GroundStudio/Jade_U1Plus/README.md

GroundStudio Jade U1+
====================================
JadeU1+

Get it from [ardushop.ro](https://ardushop.ro/ro/118-groundstudio)

Explore all the GroundStudio products at [GroundStudio.ro](https://groundstudio.ro/)

Description
-------------------
Development board based on ATmega328PB chip.

Contents
-------------------

* [/Documentation](https://github.com/GroundStudio/Jade_U1Plus/tree/main/Documentation) -- Contains documentation written during creation of this repository, with readme.md index of its own!
* [/Firmware](https://github.com/GroundStudio/Jade_U1Plus/tree/main/Firmware) -- Firmware (bootloaders, etc)
* [/Hardware](https://github.com/GroundStudio/Jade_U1Plus/tree/main/Hardware) -- Schematics, layout.
* [/Libraries](https://github.com/GroundStudio/Jade_U1Plus/tree/main/Libraries) -- Arduino/CircuitPython libraries. 
* [/Tools](https://github.com/GroundStudio) -- Tools needed for compiling, uploading bootloader, etc.

Versions
-------------------
*(Not all tags shown)*
* [V1.1.0] Initial version

License
-------------------

This is released under the [Attribution-ShareAlike 4.0 International (CC BY-SA 4.0)](https://creativecommons.org/licenses/by-sa/4.0/) license. 
**You are welcome to use this for commercial purposes.**

Please consider contributing back to this project or others to help the open-source hardware community continue to thrive and grow! 

Certifications:

[Open Source Hardware Association](https://certification.oshwa.org/ro000024.html)   
   
certification-mark-RO000024-wide (https://certification.oshwa.org/ro000024.html)
