GroundStudio/Jade_U1Plus/Documentation/REV1.1.0/REV1.1.0 OLMPHC_GS Jade U1+ Pinout.pdf

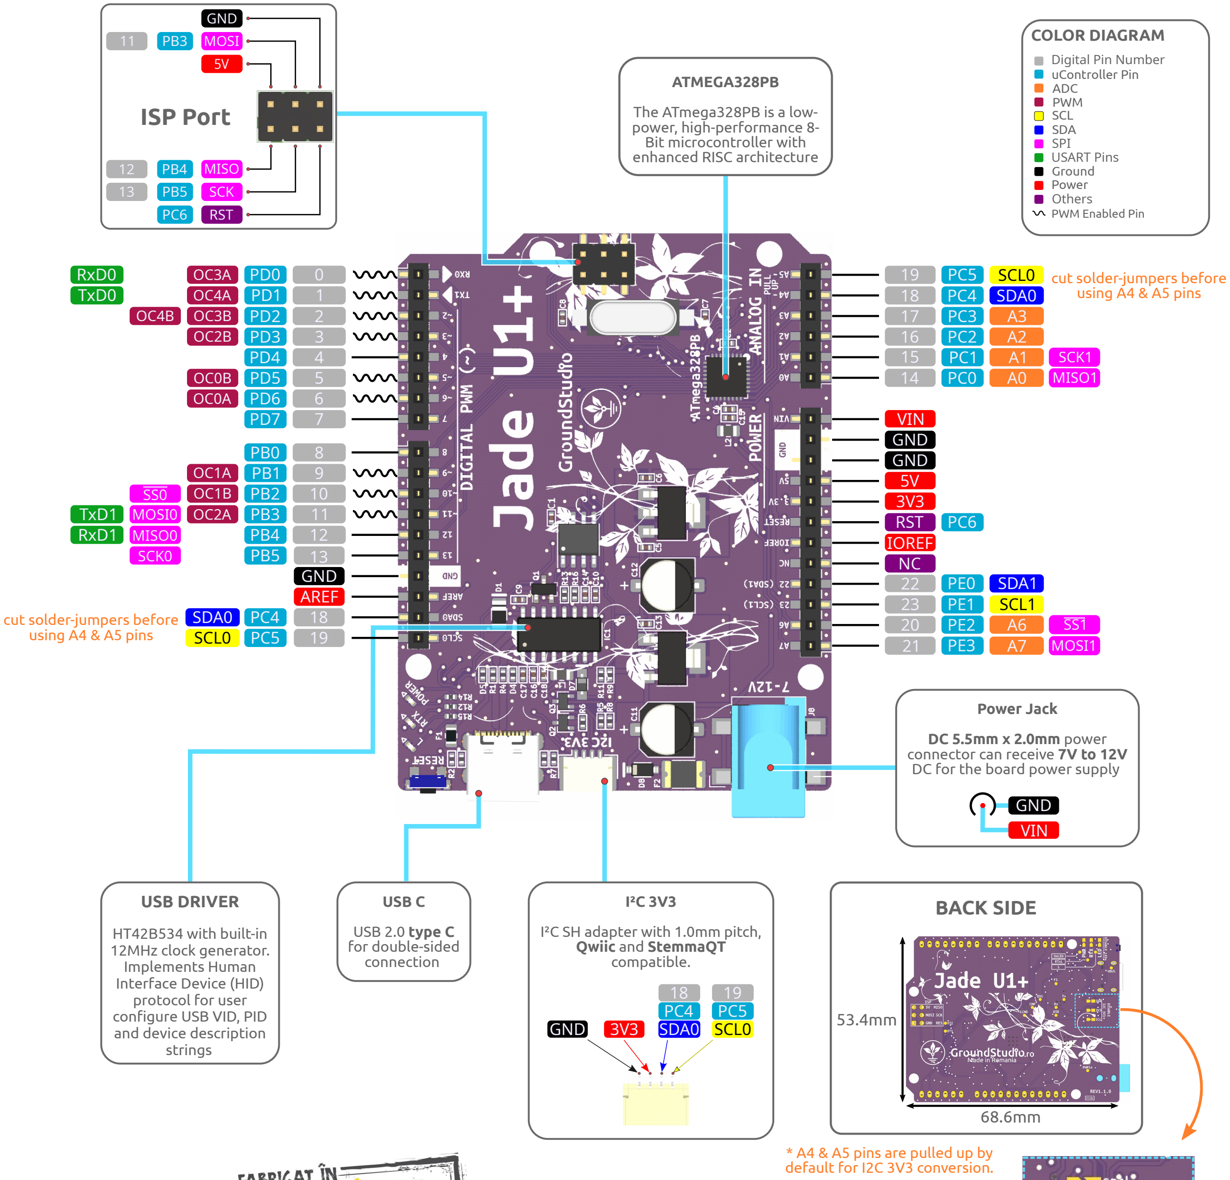
[picture p1: figure]
cut solder-jumpers before; using A4 & A5 pins; SDA0; SCL0; Digital Pin Number; SPI USART Pins; Others; uController Pin; COLOR DIAGRAM; ADC; SDA; SCL; Ground Power; ATMEGA328PB; The ATmega328PB is a low- power, high-performance 8- Bit microcontroller with enhanced RISC architecture; ISP Port; GND MOSI 5V; PB5 SCK; MISO; RST; MISO0; TxD0; RxD0; SCK0; AREF; GND; VIN; RST PC6; IOREF; Power Jack; DC 5.5mm x 2.0mm power connector can receive 7V to 12V DC for the board power supply; USB C; USB 2.0 type C for double-sided connection; USB DRIVER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
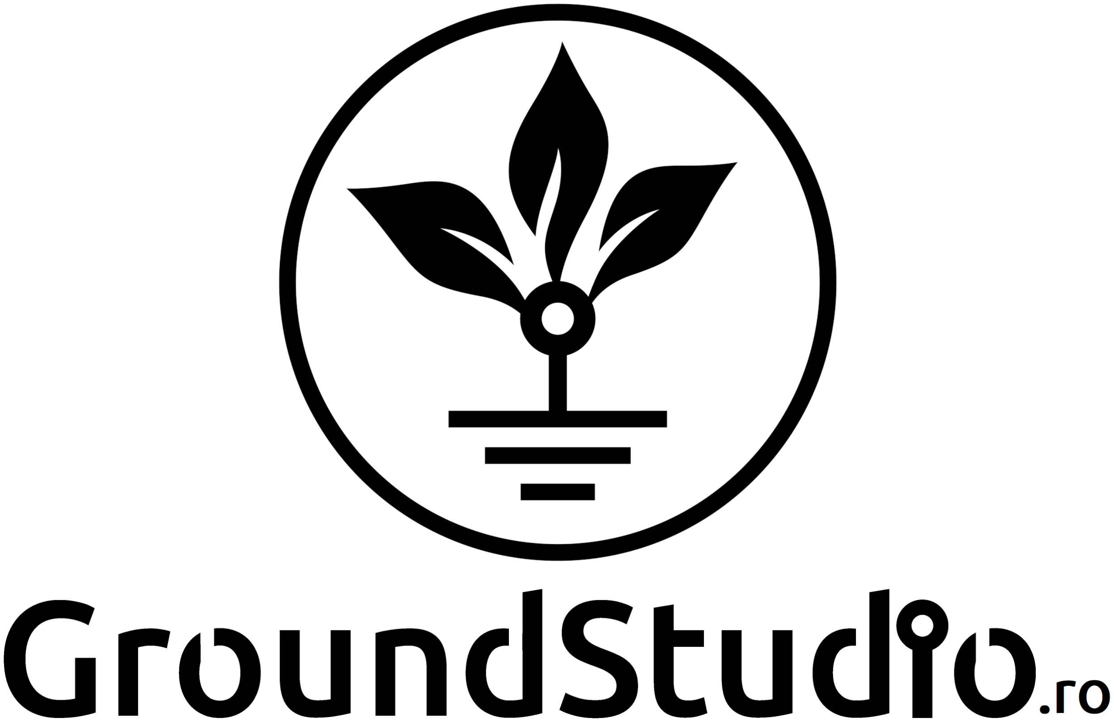
[picture p2: figure]

Board:

Credits: "Arduino UNO REV3" by Arduino (https://www.arduino.cc/en/uploads/Main/Arduino_Uno_Rev3-schematic.pdf) "GroundStudio Jade U1+" OLMPHC_GS REV 1.1.0

Copyright:

License:

ARDUSHOP SRL 2024

Attribution-ShareAlike 4.0 International

CC BY-SA 4.0 | Pinout REV: 1

# GroundStudio Jade U1+

ATMEGA328PB based development board featuring picoPower® technology for better power management, Peripheral Touch Controller (PTC), 32kBytes of In-System Self-Programmable Flash program memory, 1kBytes EEPROM, 2kBytes Internal SRAM, 10 PWM Channels, 24 Digital Pins, 2 USART, 2 SPI, 2 I²C ports with an I2C 3V3 adapter on port 0 (default) and 8 ADC Pins with 10 bit Resolution

This will cause the pins to always be HIGH!

To use A4 & A5 as regular pins detach them first from I2C 3V3 connector by cutting the solder jumpers on the backside of the pcb.
