GroundStudio/Jade_U1Plus/Documentation/REV1.1.0/REV1.1.0 OLMPHC_GS Jade U1+ Schematic.pdf

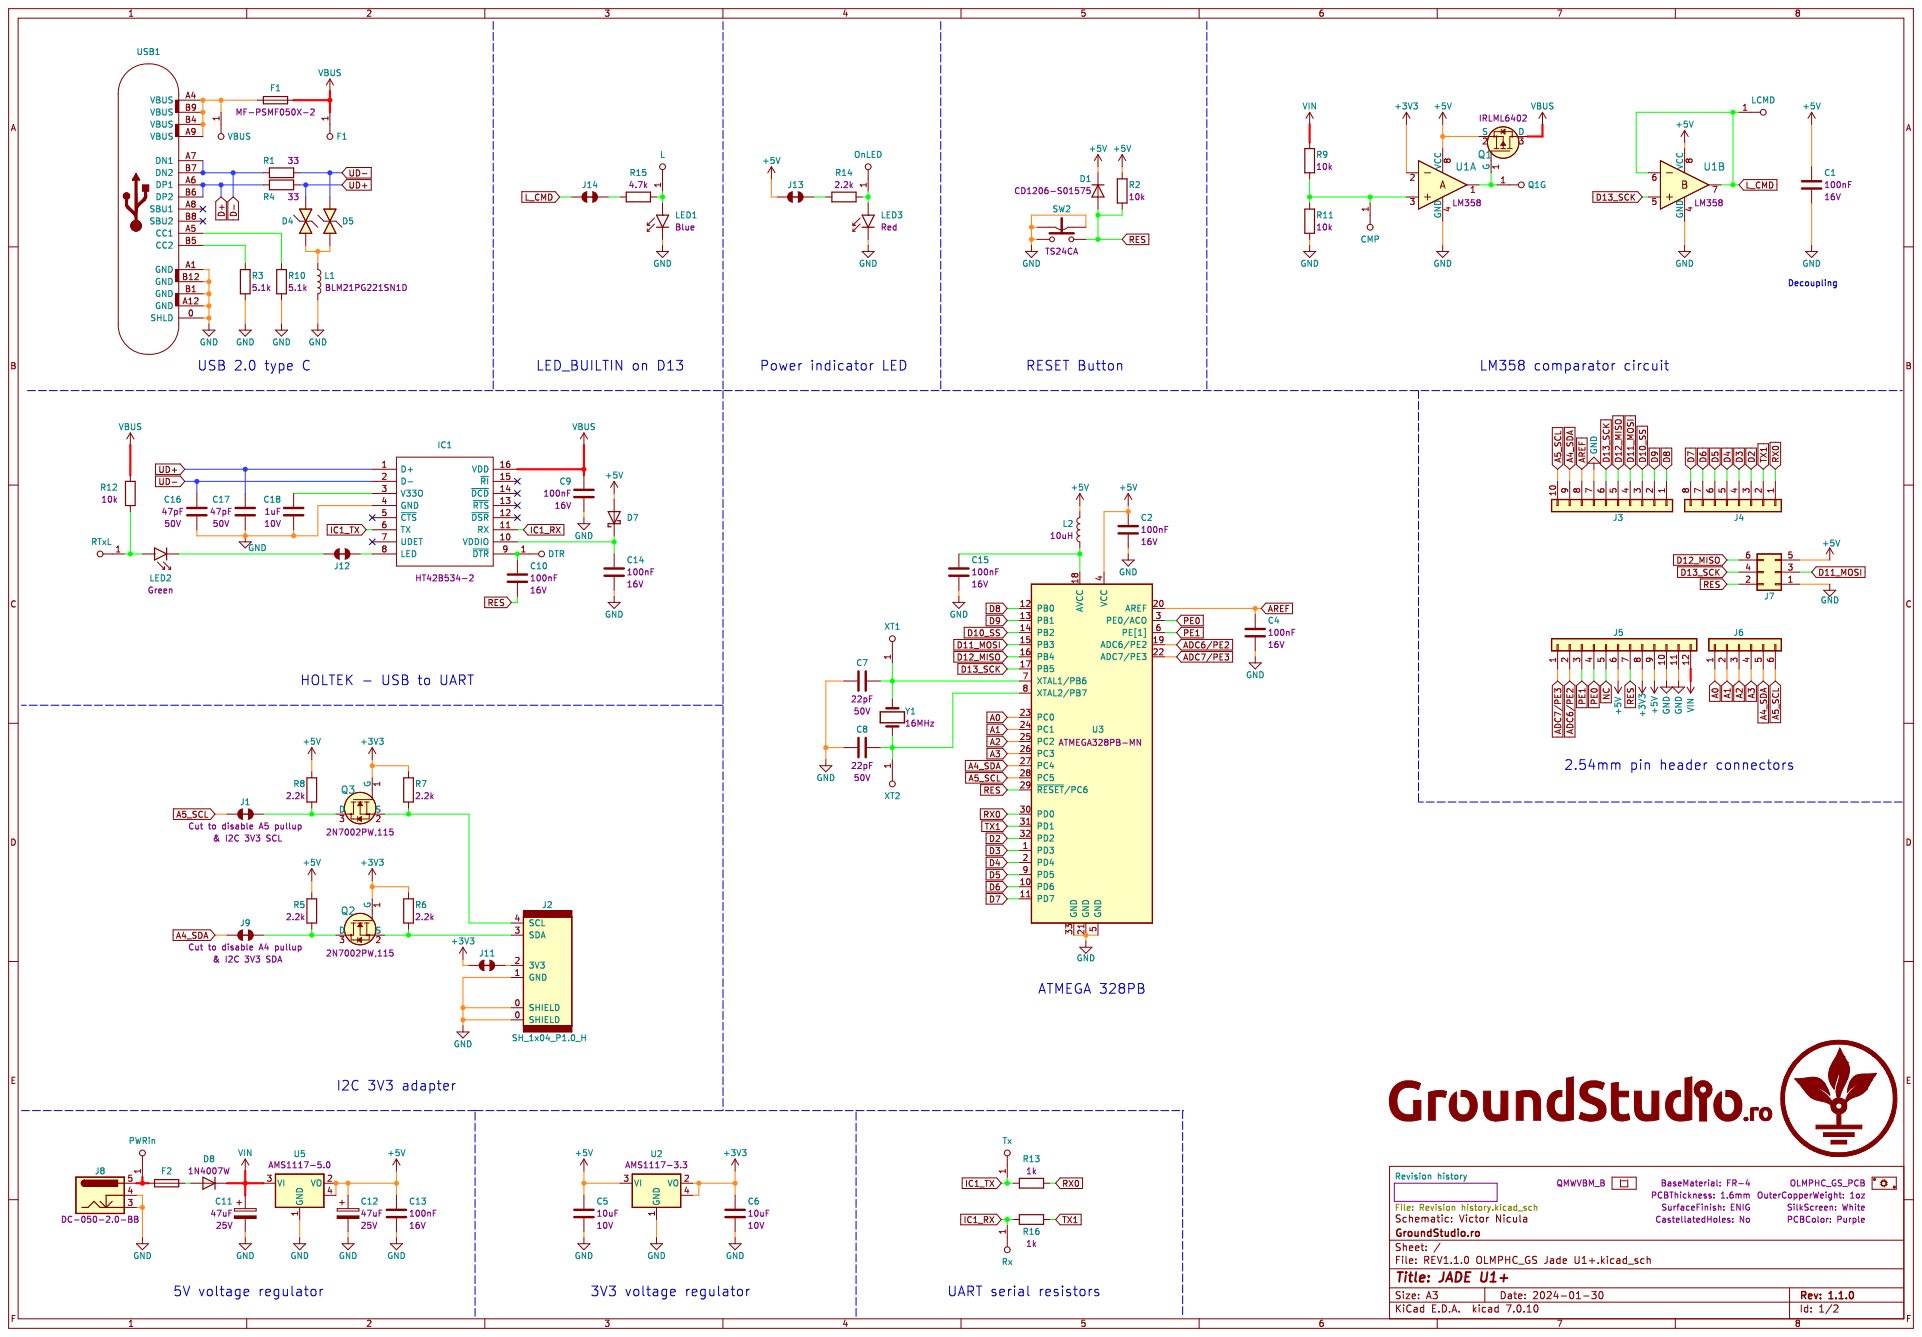
[picture p3: page 1]

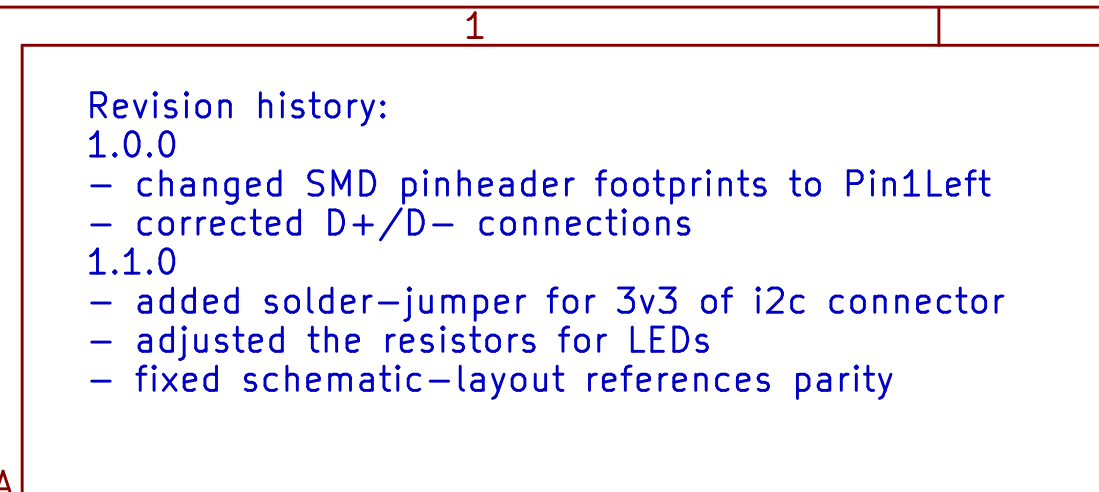
[picture p4: page 2]
